schlae/mmd1_fram80/fram80.pdf

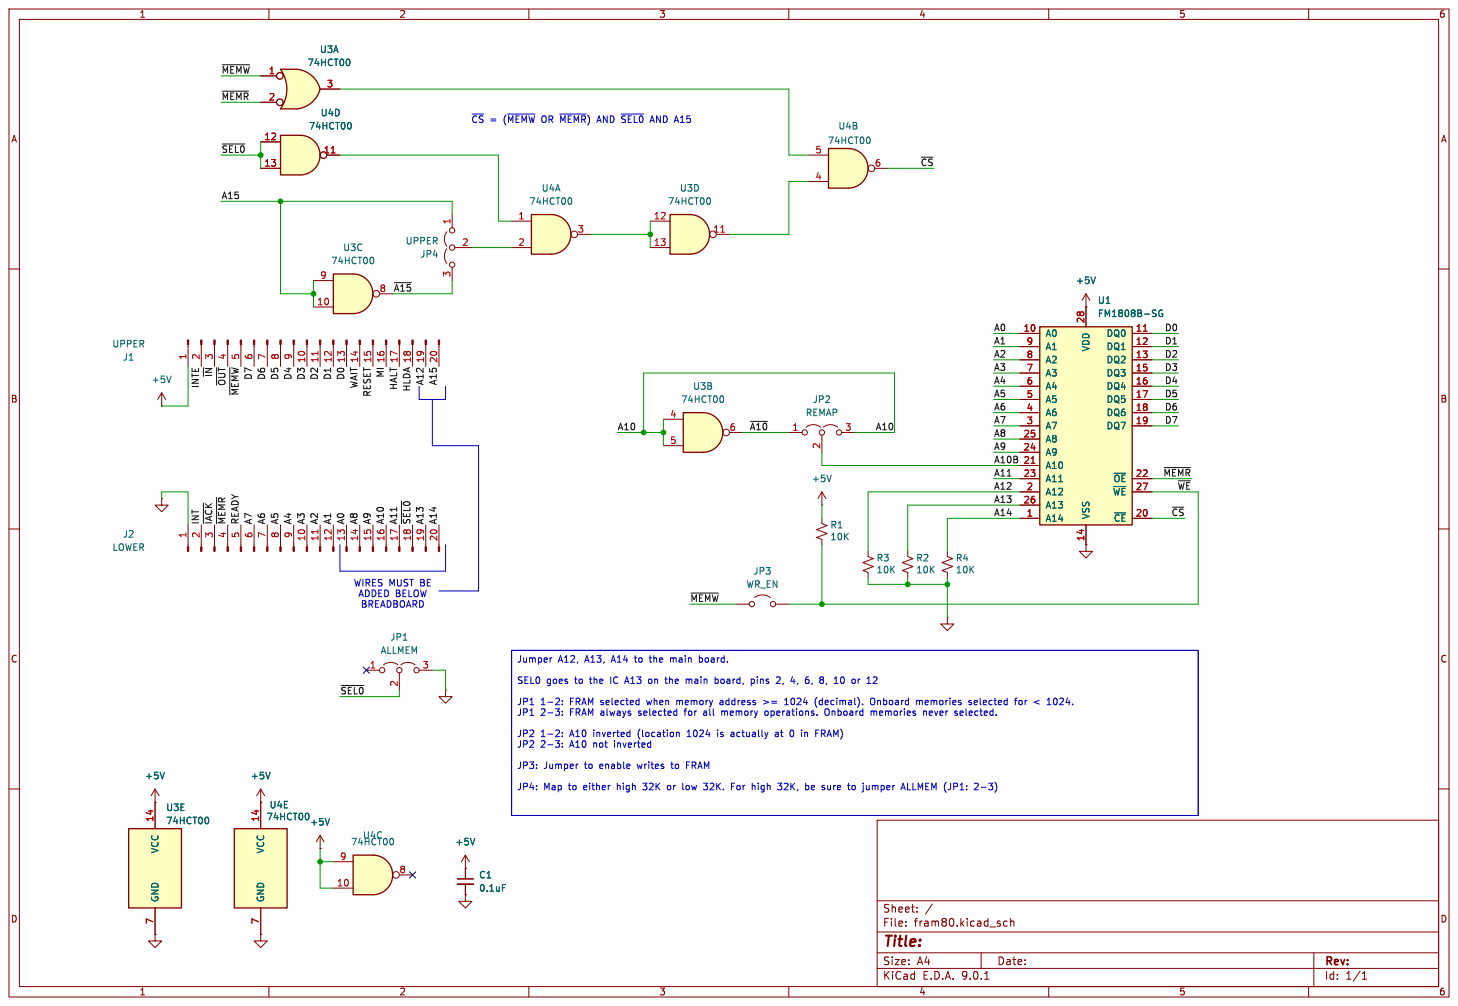
[picture p1: page 1]

~{CS}= (~{MEMW}OR ~{MEMR})AND ~{SEL0}AND A15 WIRES MUST BE

Jumper A12, A13, A14 to the main board. SEL0 goes to the IC A13 on the main board, pins 2, 4, 6, 8, 10 or 12

JP3: Jumper to enable writes to FRAM

JP4: Map to either high 32K or low 32K. For high 32K, be sure to jumper ALLMEM (JP1: 2-3)

Id: 1/1 Title: File: fram80.kicad_sch Sheet: / +5V C1
