schlae/mmd1_fram80/fram80.kicad_pcb

## KiCad design fram80.kicad_pcb (2025-08-07)

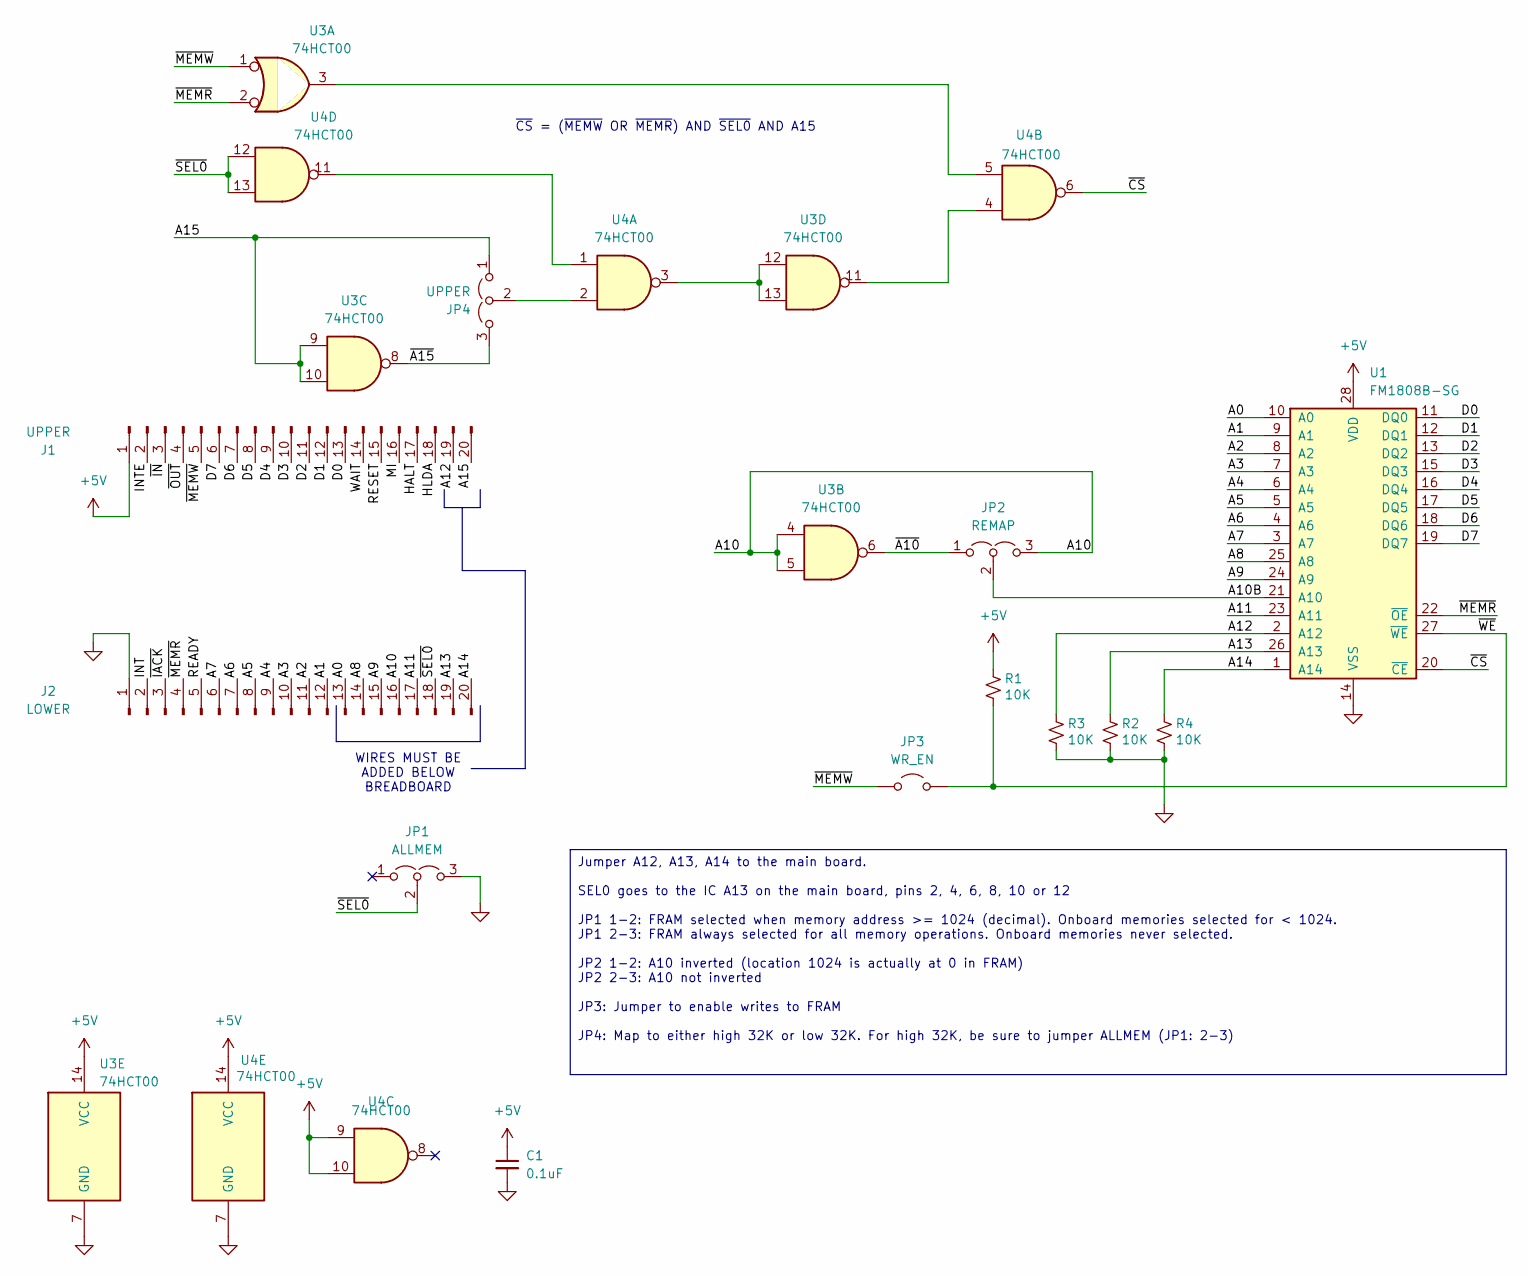
[picture p2: schematic fram80.kicad_sch]

Parts:
C1: 0.1uF; C_0805_2012Metric
J1: UPPER; 1544210-2_20
J2: LOWER; 1544210-2_20
JP1: ALLMEM; PinHeader_1x03_P2.54mm_Vertical
JP2: REMAP; PinHeader_1x03_P2.54mm_Vertical
JP3: WR_EN; PinHeader_1x02_P2.54mm_Vertical
JP4: UPPER; PinHeader_1x03_P2.54mm_Vertical
R1, R2, R3, R4: 10K; R_0805_2012Metric
U1: FM1808B-SG; SOIC-28W_7.5x17.9mm_P1.27mm
U3, U4: 74HCT00; TSSOP-14_4.4x5mm_P0.65mm

Connections:
+5V: C1.1, J1.1, R1.1, U1.28 (VDD), U3.14 (VCC), U4.9, U4.10, U4.14 (VCC)
/A0: J2.13, U1.10 (A0)
/A1: J2.12, U1.9 (A1)
/A2: J2.11, U1.8 (A2)
/A3: J2.10, U1.7 (A3)
/A4: J2.9, U1.6 (A4)
/A5: J2.8, U1.5 (A5)
/A6: J2.7, U1.4 (A6)
/A7: J2.6, U1.3 (A7)
/A8: J2.14, U1.25 (A8)
/A9: J2.15, U1.24 (A9)
/A10: J2.16, JP2.3 (B), U3.4, U3.5
/A10B: JP2.2 (C), U1.21 (A10)
/A11: J2.17, U1.23 (A11)
/A12: J1.19, R3.1, U1.2 (A12)
/A13: J2.19, R2.1, U1.26 (A13)
/A14: J2.20, R4.1, U1.1 (A14)
/A15: J1.20, JP4.1 (A), U3.9, U3.10
/D0: J1.13, U1.11 (DQ0)
/D1: J1.12, U1.12 (DQ1)
/D2: J1.11, U1.13 (DQ2)
/D3: J1.10, U1.15 (DQ3)
/D4: J1.9, U1.16 (DQ4)
/D5: J1.8, U1.17 (DQ5)
/D6: J1.7, U1.18 (DQ6)
/D7: J1.6, U1.19 (DQ7)
/HALT: J1.17
/HLDA: J1.18
/INT: J2.2
/INTE: J1.2
/MI: J1.16
/READY: J2.5
/RESET: J1.15
/WAIT: J1.14
/~A10: JP2.1 (A), U3.6
/~A15: JP4.3 (B), U3.8
/~CS: U1.20 (~CE), U4.6
/~IACK: J2.3
/~IN: J1.3
/~MEMR: J2.4, U1.22 (~OE), U3.2
/~MEMW: J1.5, JP3.1 (A), U3.1
/~OUT: J1.4
/~SEL0: J2.18, JP1.2 (C), U4.12, U4.13
/~WE: JP3.2 (B), R1.2, U1.27 (~WE)
GND: C1.2, J2.1, JP1.3 (B), R2.2, R3.2, R4.2, U1.14 (VSS), U3.7 (GND), U4.7 (GND)
unnamed: JP4.2 (C), U4.2
unnamed: U3.3, U4.5
unnamed: U3.11, U4.4
unnamed: U3.12, U3.13, U4.3
unnamed: U4.1, U4.11

Notes on the sheet:
WIRES MUST BE ADDED BELOW BREADBOARD
~{CS} = (~{MEMW} OR ~{MEMR}) AND ~{SEL0} AND A15
Jumper A12, A13, A14 to the main board. SEL0 goes to the IC A13 on the main board, pins 2, 4, 6, 8, 10 or 12 JP1 1-2: FRAM selected when memory address >= 1024 (decimal). Onboard memories selected for < 1024. JP1 2-3: FRAM always selected for all memory operations. Onboard memories never selected. 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

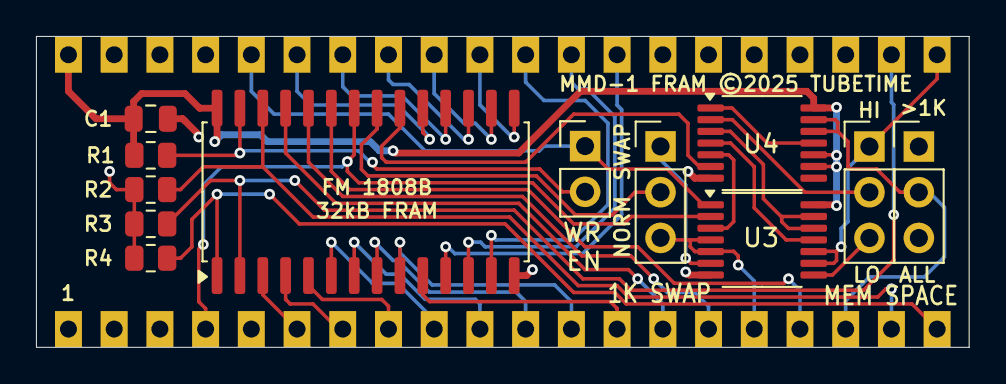
[picture p3: board fram80.kicad_pcb from above]

Board: 2 copper layers, 51.8 x 17.3 mm, 14 parts (1 on the bottom side), 39 nets.
