schlae/mmd1_fram80/(commit log)

2025-07-18 Support upper 32K
    [fram80.kicad_pcb, fram80.kicad_sch]
2025-08-07 Fab out rev 2
    [fram80.kicad_pcb]
