schlae/mmd1_fram80/(notices)

Notices in the files:
fram80.kicad_pcb:
MMD-1 FRAM ©2025 TUBETIME
